xdmattz/Plasma-Starter/README.TXT

Plasma Cutter Pilot Start Circuit

This project is for a circuit that adds a pilot arc function to a cheap chinese plasma cutter. ie. CT520D and others.
