xdmattz/Plasma-Starter/Program/Plasma Starter 3 State Machine.pdf

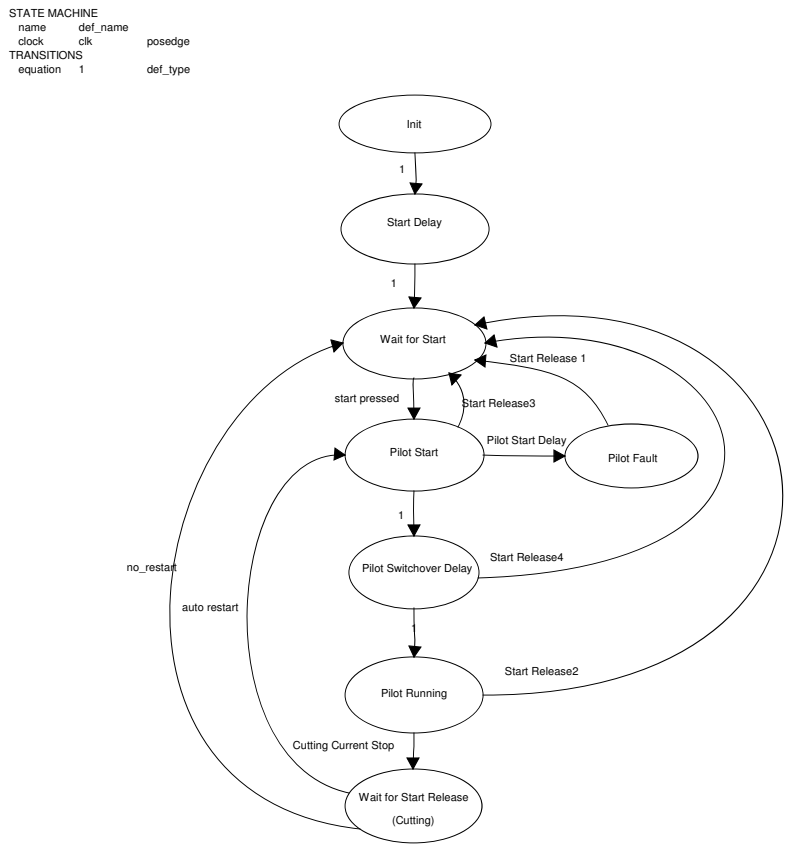
[picture p1: page 1]
STATE MACHINE; name; def_name; clock; clk; posedge; TRANSITIONS; equation; def_type; Init; Start Delay; Pilot Start; Pilot Running; (Cutting); start pressed; Pilot Fault; Start Release 1; no_restart; auto restart; Start Release2; Start Release3; Start Release4

Wait for Start

Pilot Start Delay

Pilot Switchover Delay

Cutting Current Stop

Wait for Start Release
