xdmattz/Plasma-Starter/Simulation/IGBT Drive.asc

C1: cap; 1000pF
C2: cap; 0.01µF
C3: cap; 10µF
D1: diode
L1: ind2; 370µH
L2: ind2; 850µH
M1: nmos; BSS123
R1: res; 10K
R2: res; 4.7K
R3: res; 10
V1: voltage; 12V
V2: voltage; PULSE(0 5 10us 20ns 20ns 1.3us 4.2us)
Named nets: 0, VOUT
K1 L1 L2 0.95
.tran 1ms
