xdmattz/Plasma-Starter/Simulation/IGBT Drive2.asc

C1: cap; 10µF
C2: cap; 600pF
C3: cap; 100pF
C4: cap; 4000pF
D1: schottky; MBRS1100
L1: ind2; 1.5mH
L2: ind2; 1.0mH
M1: nmos; Si9420DY
R1: res; 50
R2: res; 1K
R3: res; 10
R4: res; 200
R5: res; 4.7K
R6: res; 10K
R7: res; 2
S1: sw; myswitch
V1: voltage; PULSE(0 5 10us 20ns 20ns 1.8us 7us)
V2: voltage; 24
V3: voltage; PULSE(0 2 1ms 20ns 20ns 1ms 2ms)
Named nets: 0, VGate, VSW
K1 L1 L2 0.99
.tran 3ms
.model myswitch SW(Ron=0.1 Roff=1Meg Vt=1 Vh=0.1)
