xdmattz/Plasma-Starter/Simulation/ps2.asc

C1: cap; 0.01µF
C2: cap; 10µF
C3: cap; 0.0015µF
D1: diode
L2: ind; 0.3µH
L3: ind2; 264µH; Rser=1.5
L4: ind2; 264µH
M1: nmos; BSS123
R1: res; 2200
R2: res; 10K
R3: res; 10
V1: voltage; 12
V2: voltage; PULSE(0 5 10us 10ns 10ns 1.8us 5us 100)
Named nets: 0
k1 l3 l4 1.0
.tran 5ms
