xdmattz/Plasma-Starter/KiCAD/Plasma_Pilot4/Plasma_Pilot4.kicad_pcb

## KiCad design KiCAD/Plasma_Pilot4/Plasma_Pilot4.kicad_pcb (2019-12-01)

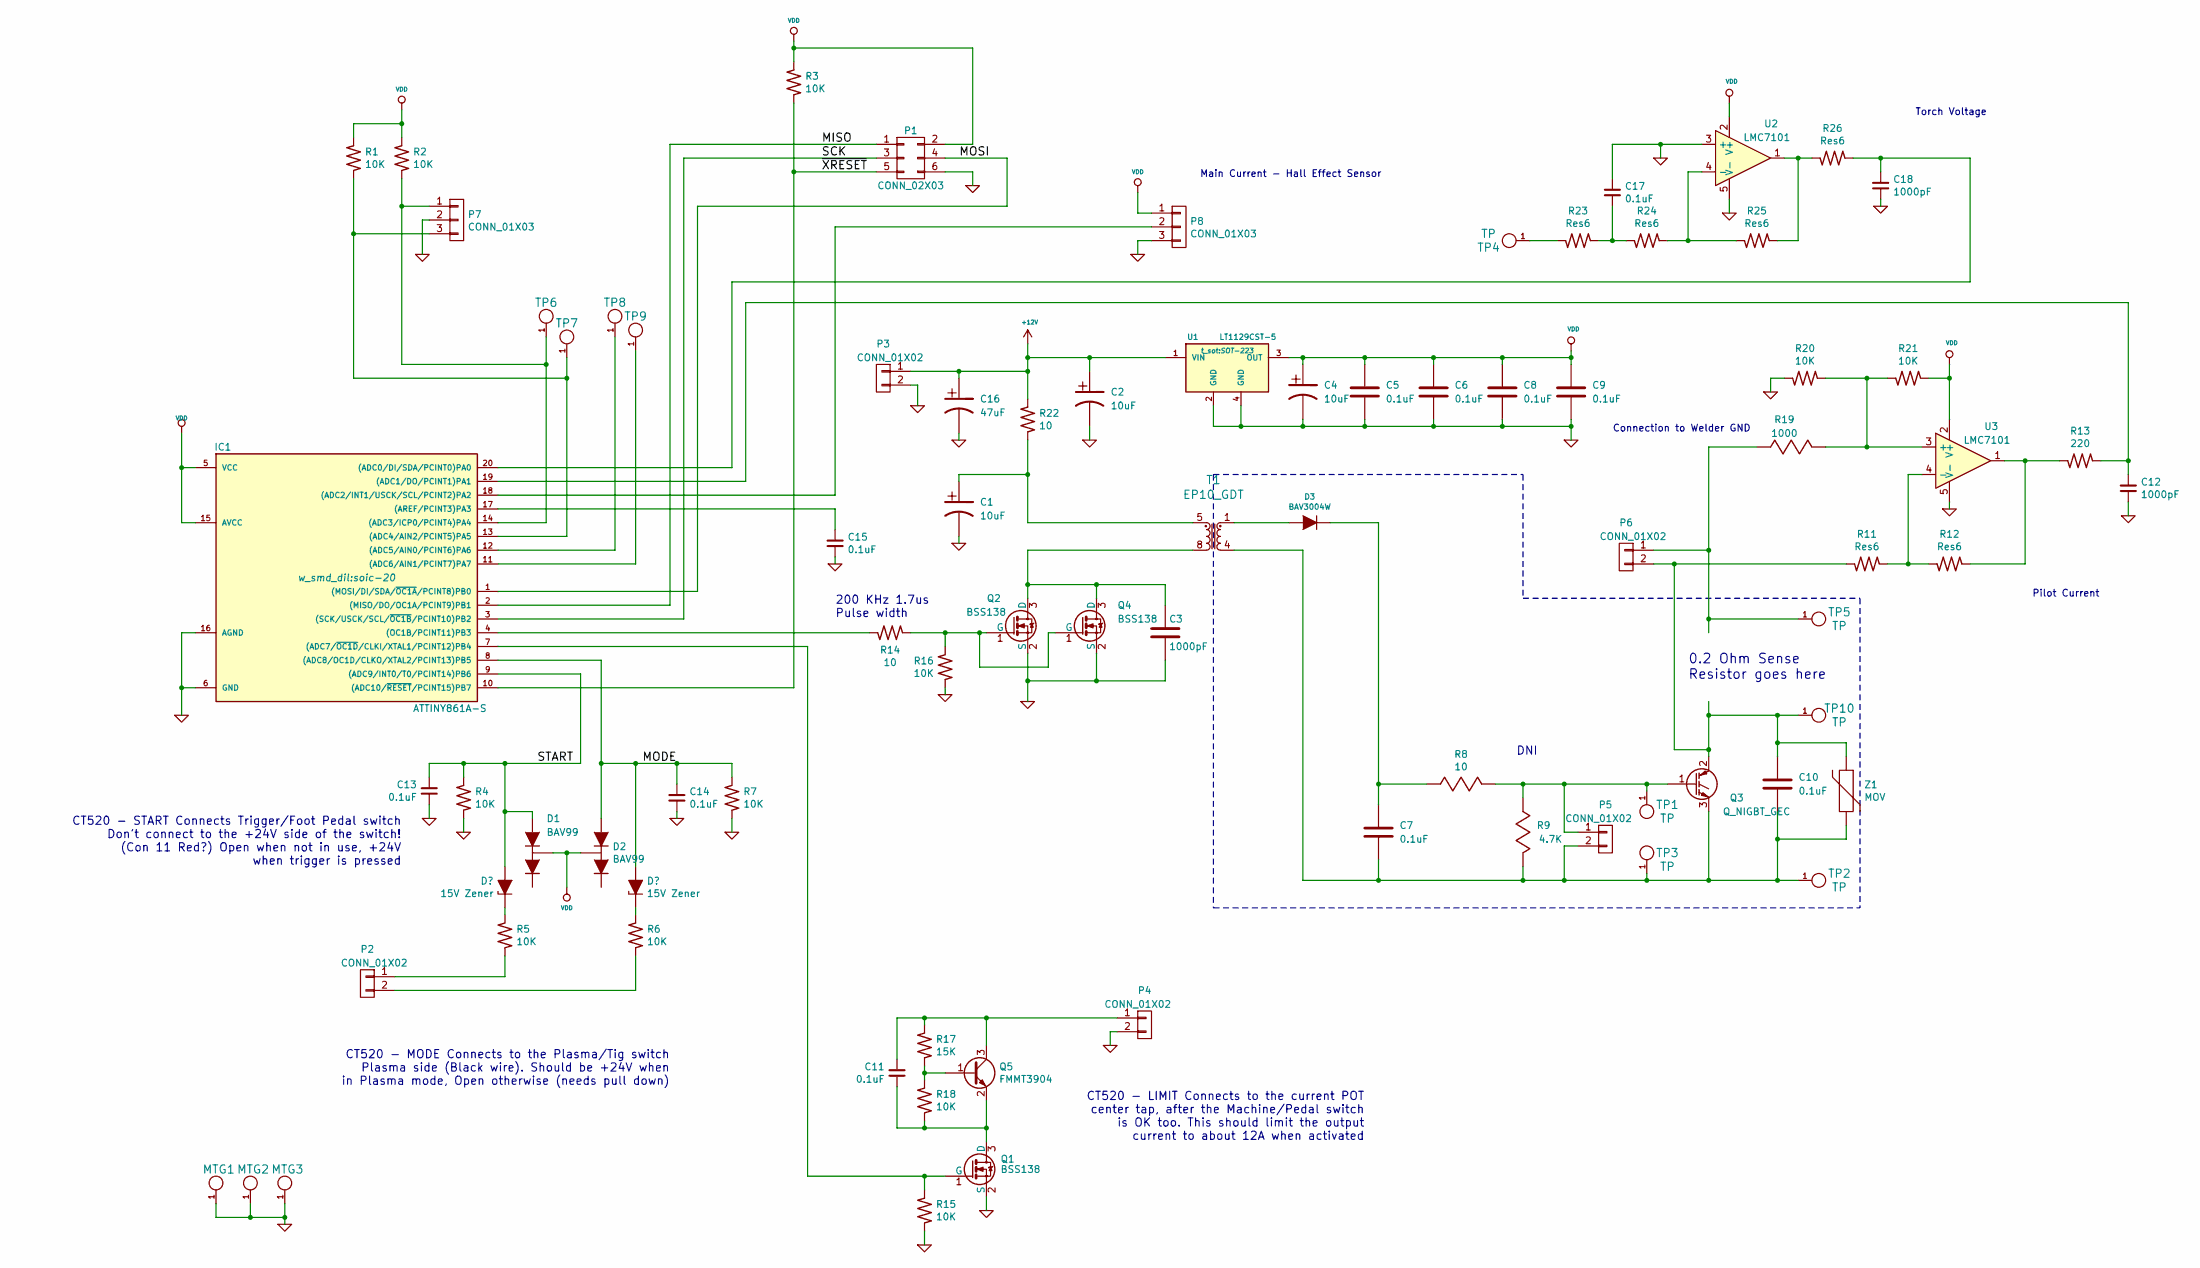
[picture p2: schematic Plasma_Pilot4.sch]

Parts:
C1, C2, C4: 10uF; cap_1210
C3: 1000pF; cap_0805
C5, C6, C11, C13, C14, C15, C17: 0.1uF; cap_0603
C7, C8, C9: 0.1uF; cap_0805
C10: 0.1uF; Cap_Rad_13x6mm
C12, C18: 1000pF; cap_0603
C16: 47uF; CP_Elec_8x6.9
D1, D2: BAV99; sot-23
D3: BAV3004W; D_SOD-123F
IC1: ATTINY861A-S; soic-20
MTG1, MTG2, MTG3: TP; MTG_200_125D
P1: CONN_02X03; PinHeader_2x03_P2.54mm_Vertical
P2, P3, P4, P5, P6: CONN_01X02; TerminalBlock5_08mm_x2
P7, P8: CONN_01X03; TerminalBlock_Phoenix_MKDS-1,5-3-5.08_1x03_P5.08mm_Horizont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
Q1, Q2, Q4: BSS138; sot-23
Q3: Q_NIGBT_GEC; TO-247-3_Vertical
Q5: FMMT3904; SOT-23
R1, R2, R3, R4, R7, R15, R16, R18, R20, R21: 10K; res_0603
R5, R6: 10K; res_1206
R8: 10; res_0805
R9: 4.7K; res_0805
R11, R12, R24, R25, R26: Res6; res_0603
R13: 220; res_0603
R14: 10; res_0603
R17: 15K; res_0603
R19: 1000; res_0805
R22: 10; res_1206
R23: Res6; res_1206
T1: EP10_GDT; EP10_SMT
TP1, TP3, TP4: TP; TP80
TP2, TP10: TP; TP160
TP5: TP; TP100
TP6, TP7, TP8, TP9: TP; TP50
U1: LT1129CST-5; SOT-223
U2, U3: LMC7101; sot-23-5
Z1: MOV; MOV_20mm

Connections:
+12V: C2.1, C16.1, P3.1, R22.2, U1.1 (VIN)
/MISO: IC1.2 ((MISO/DO/OC1A/PCINT9)PB1), P1.1
/MODE: C14.1, D2.1 (A1), IC1.8 ((ADC8/OC1D/CLKO/XTAL2/PCINT13)PB5), R6.1, R7.1
/MOSI: IC1.1 ((MOSI/DI/SDA/~OC1A~/PCINT8)PB0), P1.4
/SCK: IC1.3 ((SCK/USCK/SCL/~OC1B~/PCINT10)PB2), P1.3
/START: C13.1, D1.1 (A1), IC1.9 ((ADC9/INT0/T0/PCINT14)PB6), R4.1, R5.1
/~XRESET: IC1.10 ((ADC10/~RESET~/PCINT15)PB7), P1.5, R3.2
GND: C1.2, C2.2, C3.2, C4.2, C5.2, C6.2, C8.2, C9.2, C12.2, C13.2, C14.2, C15.2, C16.2, C17.1, C18.2, IC1.6 (GND), IC1.16 (AGND), MTG1.1, MTG2.1, MTG3.1, P1.6, P3.2, P4.2, P7.2, P8.3, Q1.2 (S), Q2.2 (S), Q4.2 (S), R4.2, R7.2, R15.2, R16.1, R20.2, U1.2 (GND), U1.4 (GND), U2.3 (+), U2.5 (V-), U3.5 (V-)
unnamed: C1.1, R22.1, T1.5 (P1)
unnamed: C3.1, Q2.3 (D), Q4.3 (D), T1.8 (P2)
unnamed: C7.1, D3.2 (K), R8.1
unnamed: C10.1, P6.2, Q3.2 (C), R11.2, TP10.1, Z1.1
unnamed: C7.2, C10.2, P5.2, Q3.3 (E), R9.2, T1.4 (S2), TP2.1, TP3.1, Z1.2
unnamed: C11.1, P4.1, Q5.3 (C), R17.1
unnamed: C11.2, Q1.3 (D), Q5.2 (E), R18.2
unnamed: C12.1, IC1.19 ((ADC1/DO/PCINT1)PA1), R13.1
unnamed: C15.1, IC1.17 ((AREF/PCINT3)PA3)
unnamed: C17.2, R23.1, R24.2
unnamed: C18.1, IC1.20 ((ADC0/DI/SDA/PCINT0)PA0), R26.1
unnamed: D3.1 (A), T1.1 (S1)
unnamed: IC1.4 ((OC1B/PCINT11)PB3), R14.2
unnamed: IC1.7 ((ADC7/~OC1D~/CLKI/XTAL1/PCINT12)PB4), Q1.1 (G), R15.1
unnamed: IC1.11 ((ADC6/AIN1/PCINT7)PA7), TP9.1
unnamed: IC1.12 ((ADC5/AIN0/PCINT6)PA6), TP8.1
unnamed: IC1.13 ((ADC4/AIN2/PCINT5)PA5), P7.3, R1.2, TP7.1
unnamed: IC1.14 ((ADC3/ICP0/PCINT4)PA4), P7.1, R2.2, TP6.1
unnamed: IC1.18 ((ADC2/INT1/USCK/SCL/PCINT2)PA2), P8.2
unnamed: P2.1, R5.2
unnamed: P2.2, R6.2
unnamed: P5.1, Q3.1 (G), R8.2, R9.1, TP1.1
unnamed: P6.1, R19.1, TP5.1
unnamed: Q2.1 (G), Q4.1 (G), R14.1, R16.2
unnamed: Q5.1 (B), R17.2, R18.1
unnamed: R11.1, R12.2, U3.4 (-)
unnamed: R12.1, R13.2, U3.1
unnamed: R19.2, R20.1, R21.2, U3.3 (+)
unnamed: R23.2, TP4.1
unnamed: R24.1, R25.2, U2.4 (-)
unnamed: R25.1, R26.2, U2.1
VDD: C4.1, C5.1, C6.1, C8.1, C9.1, D1.3 (KA), D2.3 (KA), IC1.5 (VCC), IC1.15 (AVCC), P1.2, P8.1, R1.1, R2.1, R3.1, R21.1, U1.3 (OUT), U2.2 (V+), U3.2 (V+)

Notes on the sheet:
DNI
CT520 - MODE Connects to the Plasma/Tig switch Plasma side (Black wire). Should be +24V when in Plasma mode, Open otherwise (needs pull down)
CT520 - START Connects Trigger/Foot Pedal switch Don't connect to the +24V side of the switch! (Con 11 Red?) Open when not in use, +24V when trigger is pressed
CT520 - LIMIT Connects to the current POT center tap, after the Machine/Pedal switch is OK too. This should limit the output current to about 12A when activated
200 KHz 1.7us Pulse width
Connection to Welder GND
Pilot Current
Torch Voltage
Main Current - Hall Effect Sensor
0.2 Ohm Sense Resistor goes here

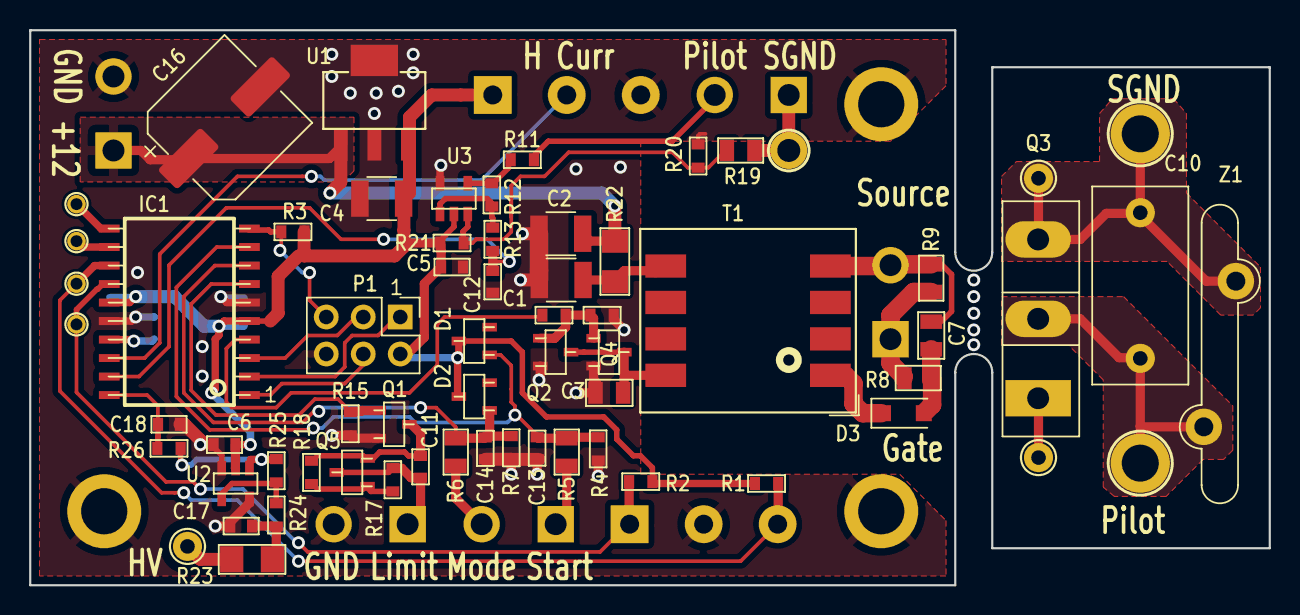
[picture p3: board Plasma_Pilot4.kicad_pcb from above]

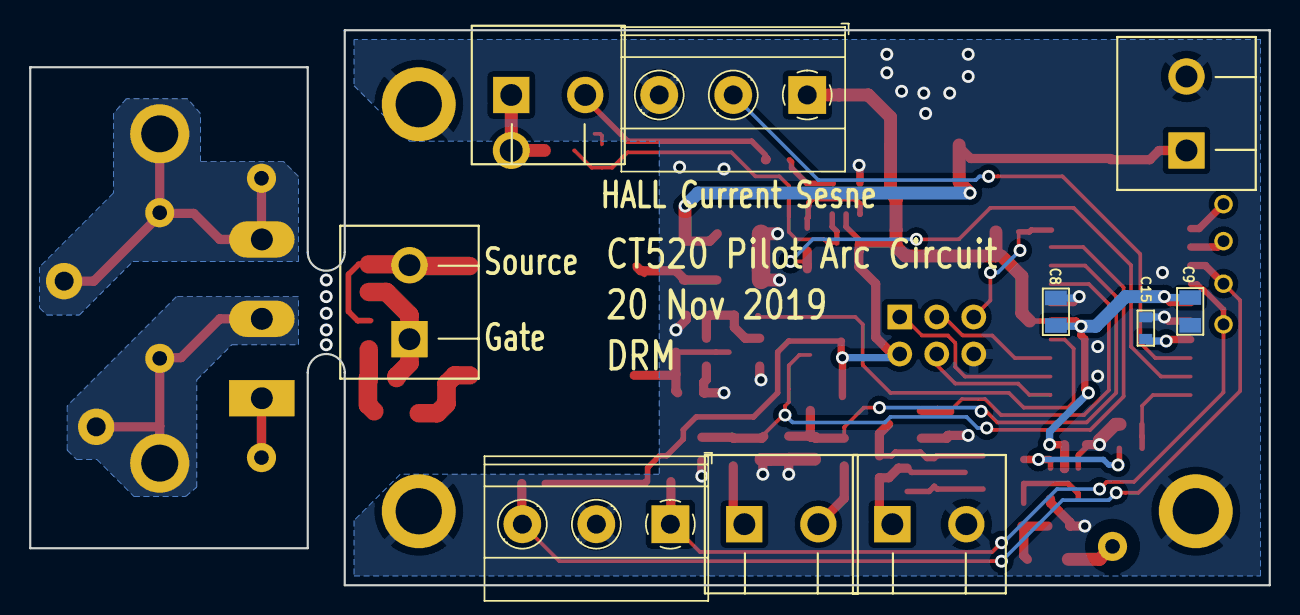
[picture p4: board Plasma_Pilot4.kicad_pcb from below]

Board: 2 copper layers, 85.1 x 38.1 mm, 78 parts (10 on the bottom side), 40 nets.
