xdmattz/Plasma-Starter/Test Data/IGBT Drive measured at FET Drain.png

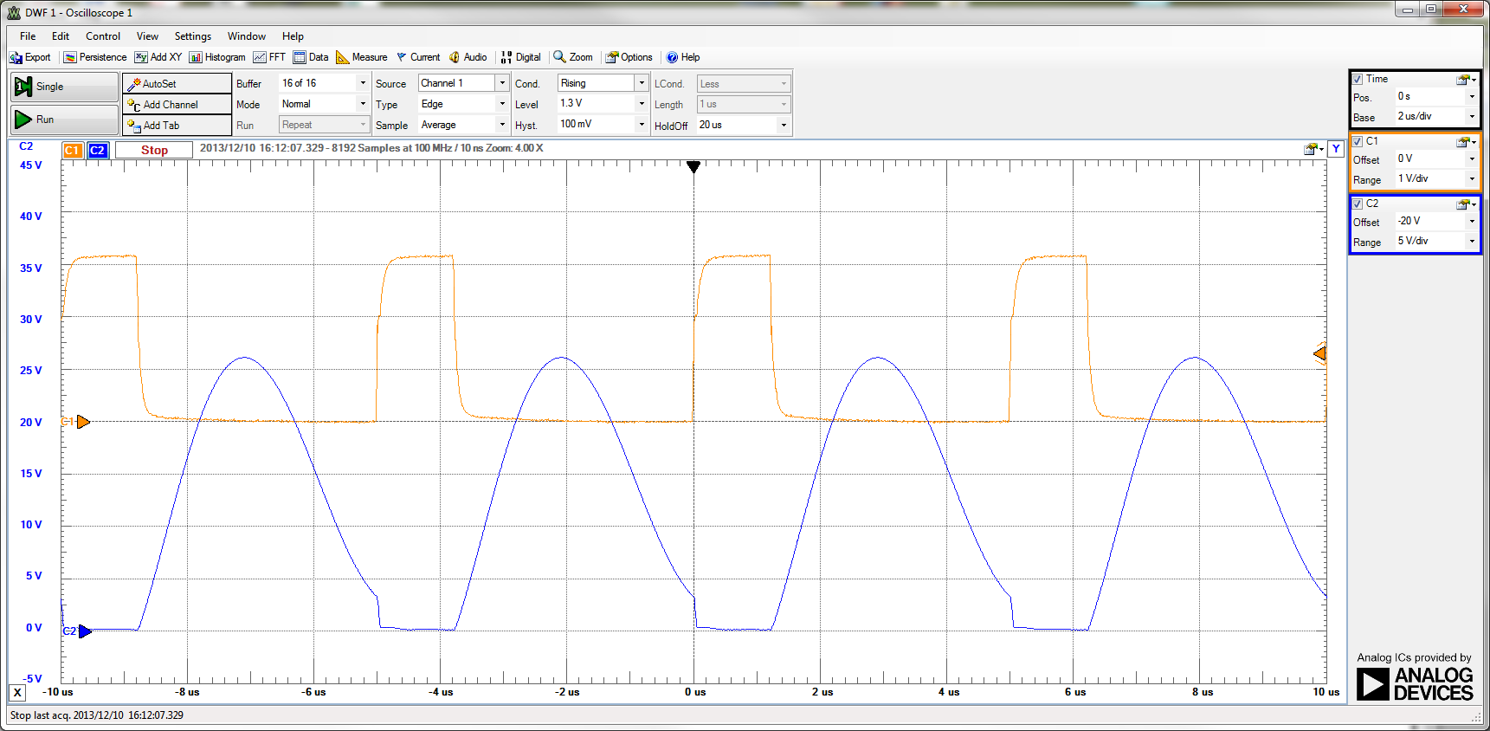
Test Data/IGBT Drive measured at FET Drain.png
