xdmattz/Plasma-Starter/(commit log)

2019-12-05 Started the next schematic rev Plasma Pilot4
    [Plasma_Pilot4.kicad_pcb, Plasma_Pilot4.sch]
2020-01-18 Added new transformer fixed code to work on CT600 plasma cutter
    [Plasma_Pilot4.sch]
